MotorDynamicsLab/Nitehawk-SB-V2/Hardware/Nitehawk-SB_V2.0.0/Nitehawk-SB_V2.0.0_Layout.png

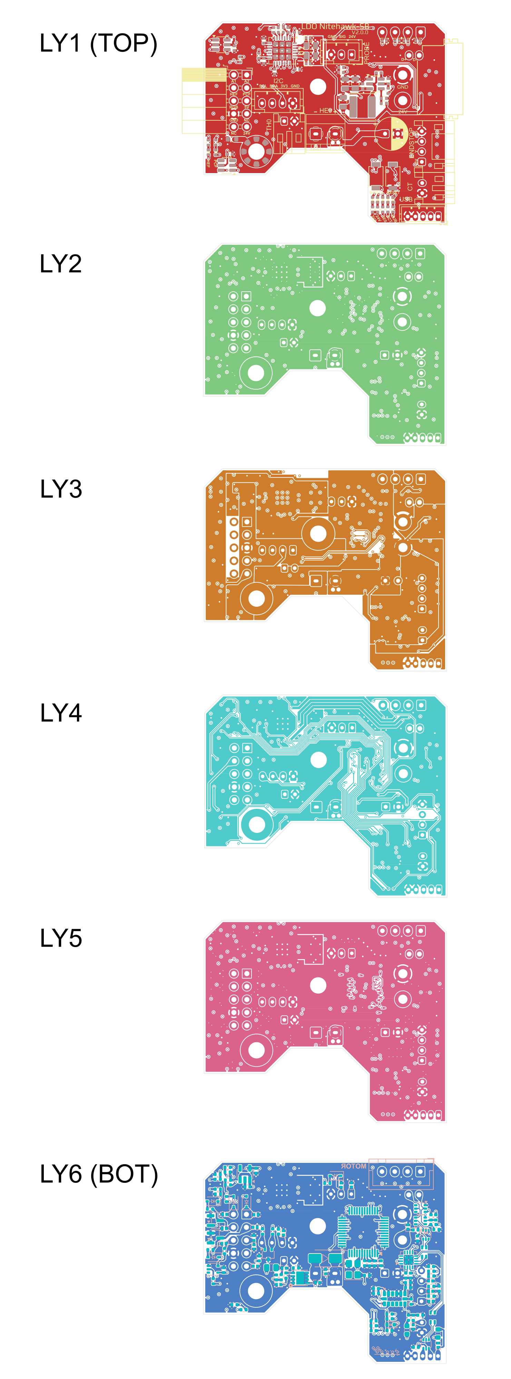
Hardware/Nitehawk-SB_V2.0.0/Nitehawk-SB_V2.0.0_Layout.png
