MotorDynamicsLab/Nitehawk-SB-V2/Images/block_diagram.jpg

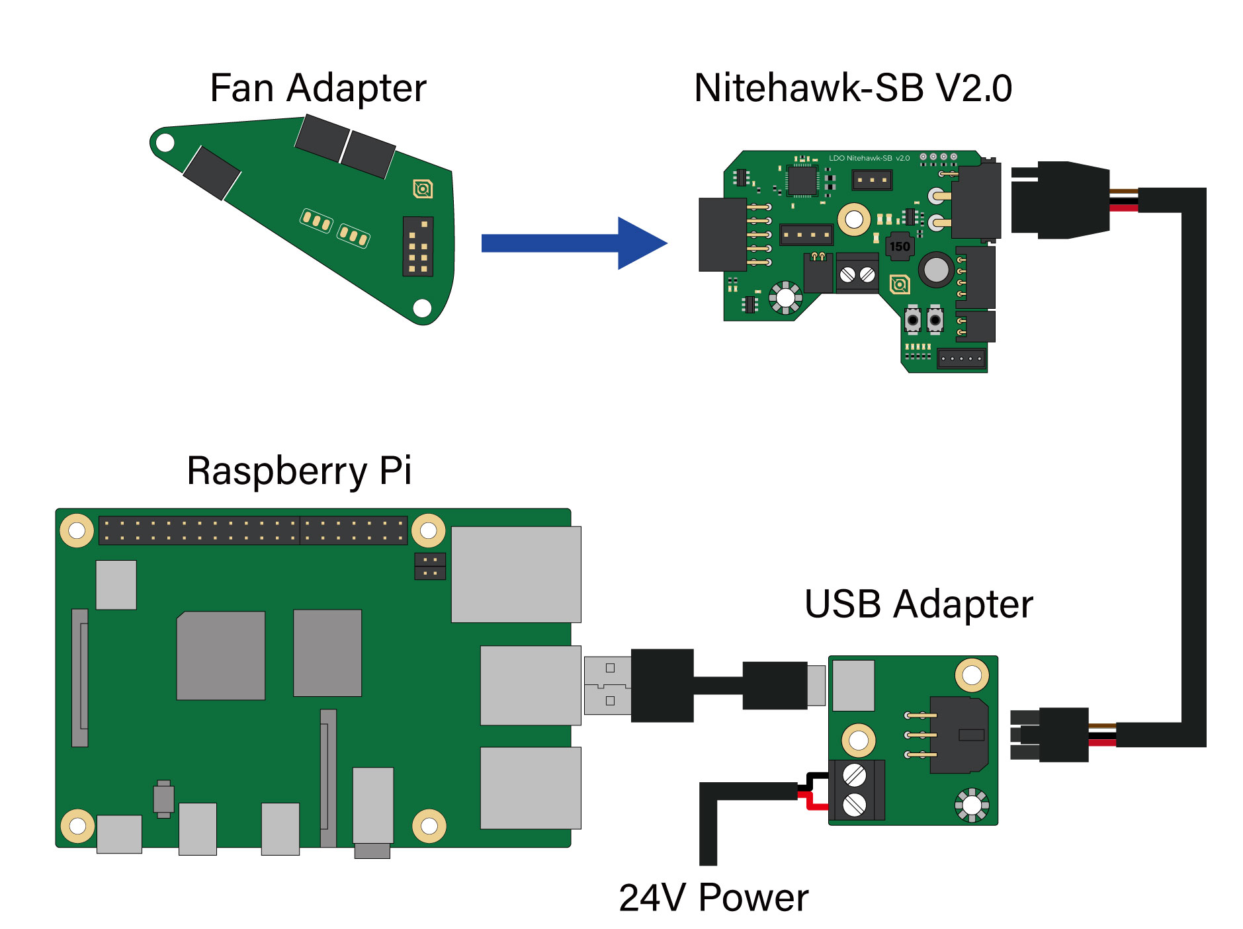
Images/block_diagram.jpg
