MotorDynamicsLab/Nitehawk-SB-V2/Images/cable_chain_ties.jpg

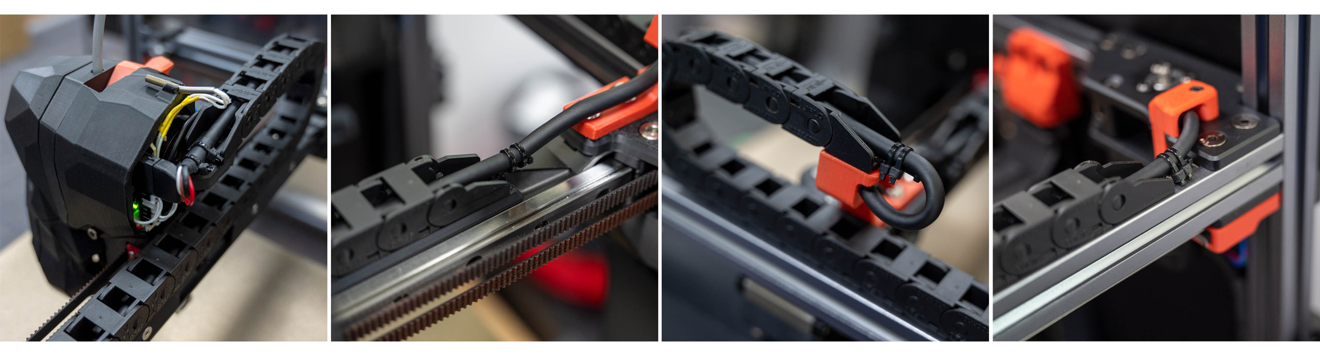
Images/cable_chain_ties.jpg
