MotorDynamicsLab/Nitehawk-SB-V2/Images/grounding_scheme.jpg

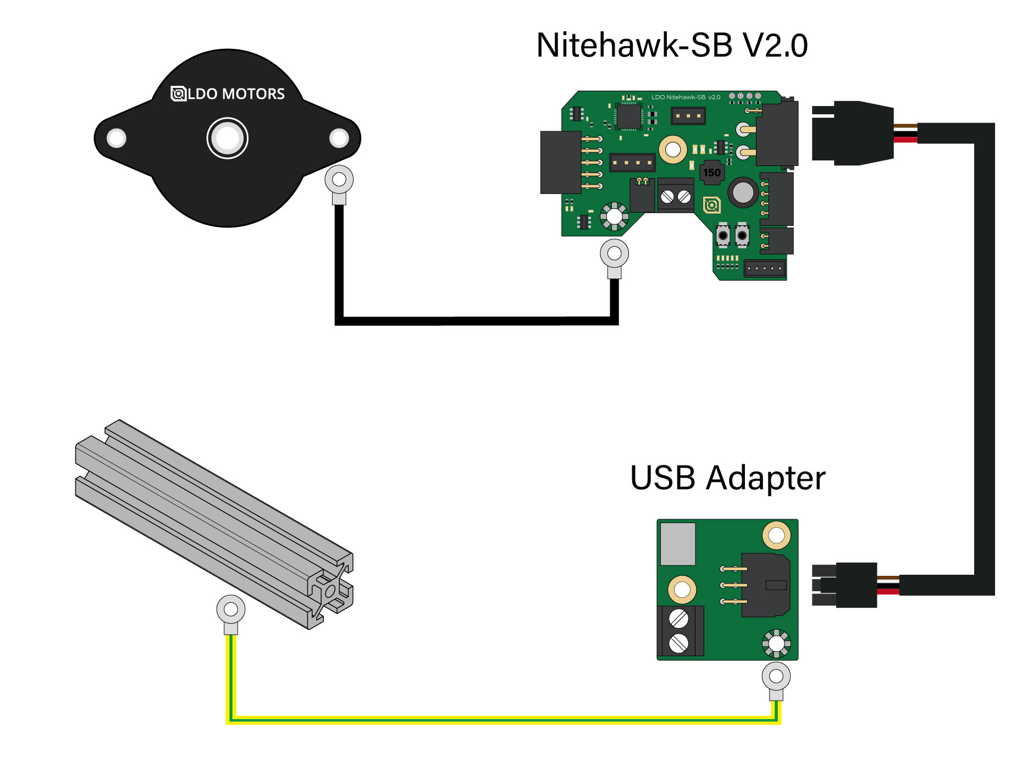
Images/grounding_scheme.jpg
