MotorDynamicsLab/Nitehawk-SB-V2/Images/katapult_menuconfig.png

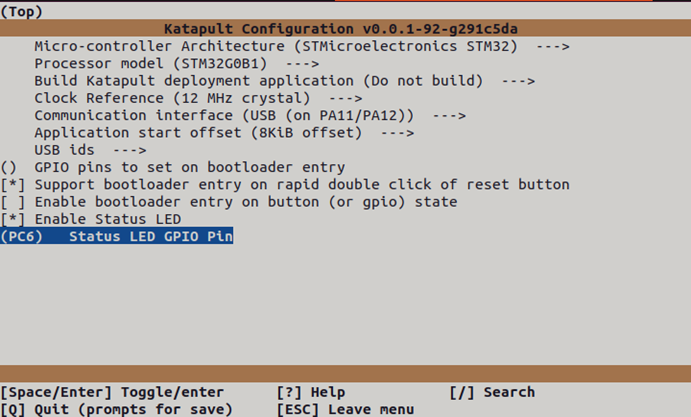
Images/katapult_menuconfig.png
