MotorDynamicsLab/Nitehawk-SB-V2/Images/nhsbv2_pcb_pinout.jpg

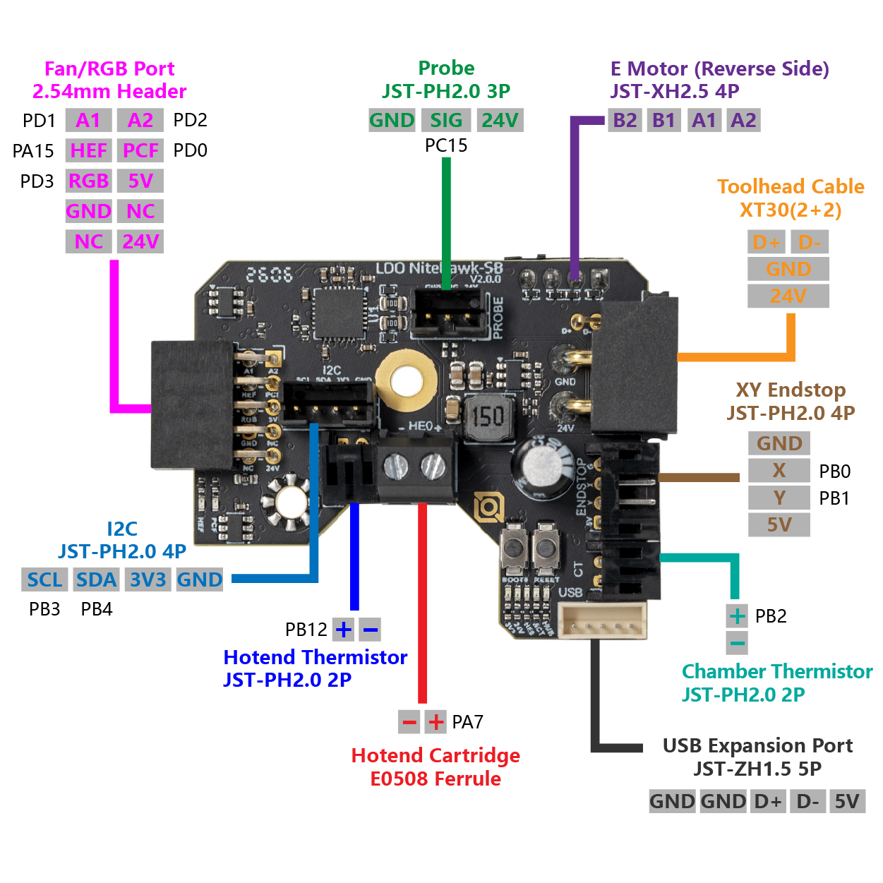
Images/nhsbv2_pcb_pinout.jpg
