MotorDynamicsLab/Nitehawk-SB-V2/Images/reset_boot_buttons.jpg

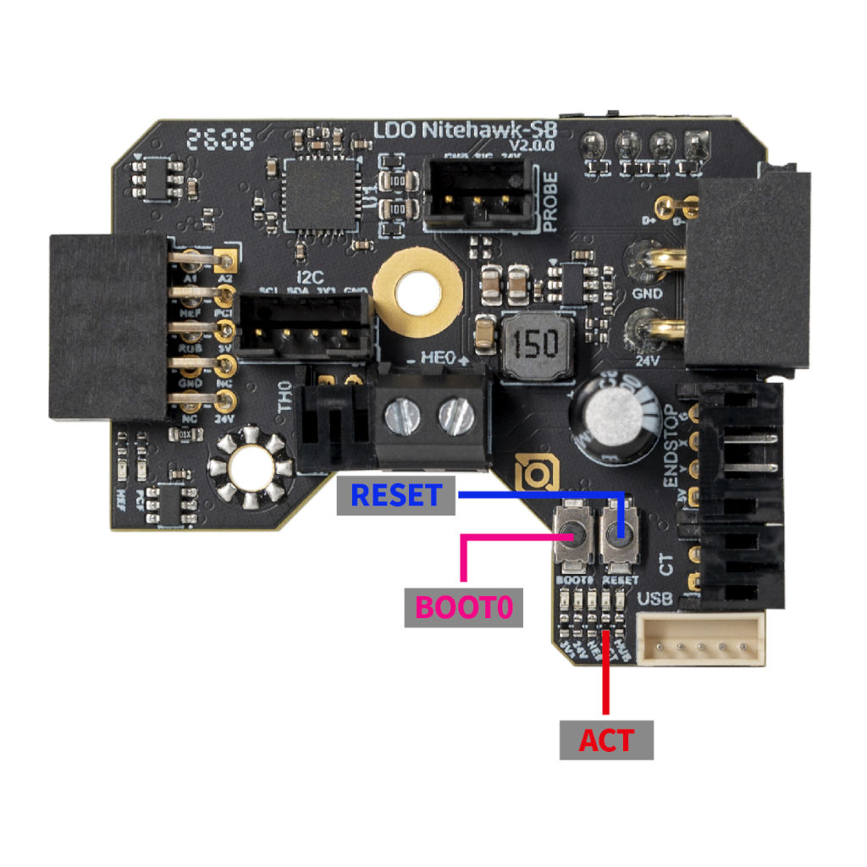
Images/reset_boot_buttons.jpg
