MotorDynamicsLab/Nitehawk-SB-V2/Images/sbv2_fan_adapter_pcb_pinout.jpg

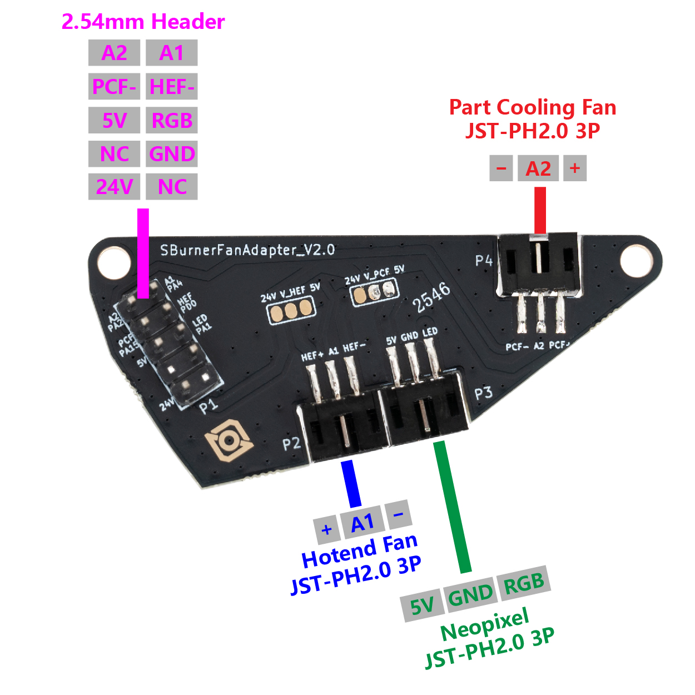
Images/sbv2_fan_adapter_pcb_pinout.jpg
