MotorDynamicsLab/Nitehawk-SB-V2/Images/toolboard_ground_routing.jpg

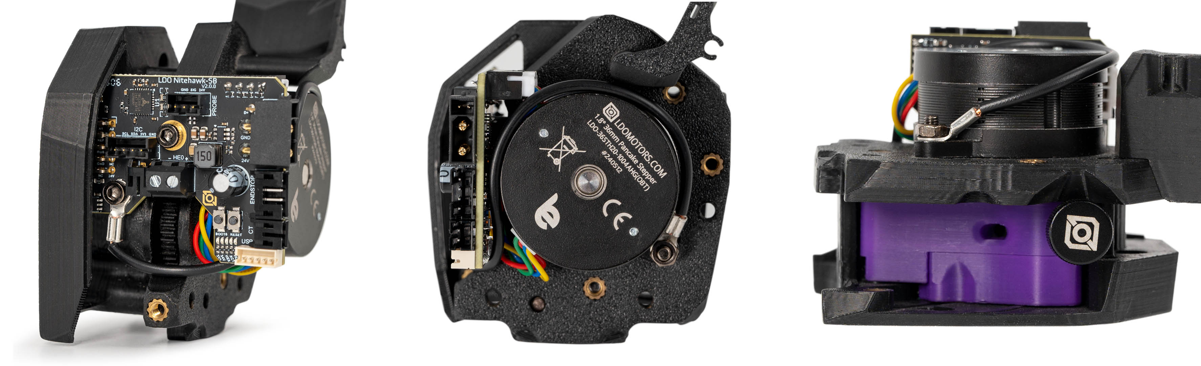
Images/toolboard_ground_routing.jpg
