MotorDynamicsLab/Nitehawk-SB-V2/Images/usb_adapter_gnd.jpg

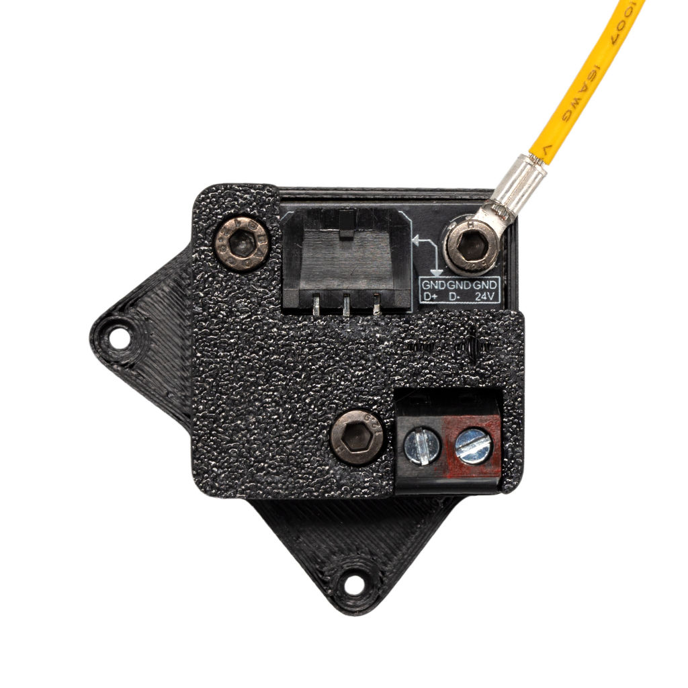
Images/usb_adapter_gnd.jpg
