MotorDynamicsLab/Nitehawk-SB-V2/STLs/usb_adapter_mount_partial_cover.stl

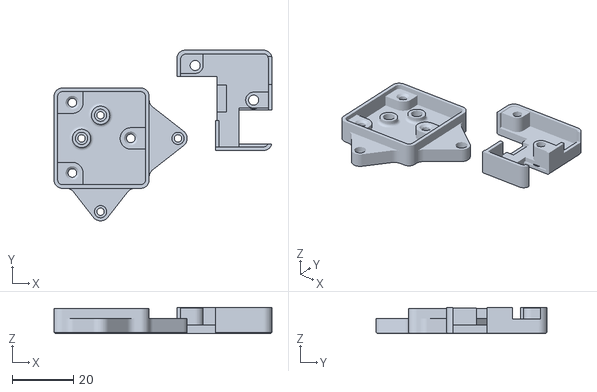
[picture p12: CAD file, 2026-01-09]
STLs/usb_adapter_mount_partial_cover.stl
71.2 x 55.8 x 8.60
