MotorDynamicsLab/Nitehawk-SB-V2/Hardware/Nitehawk-SB_V2.0.0/Nitehawk-SB_V2.0.0_Schematics.pdf.pdf

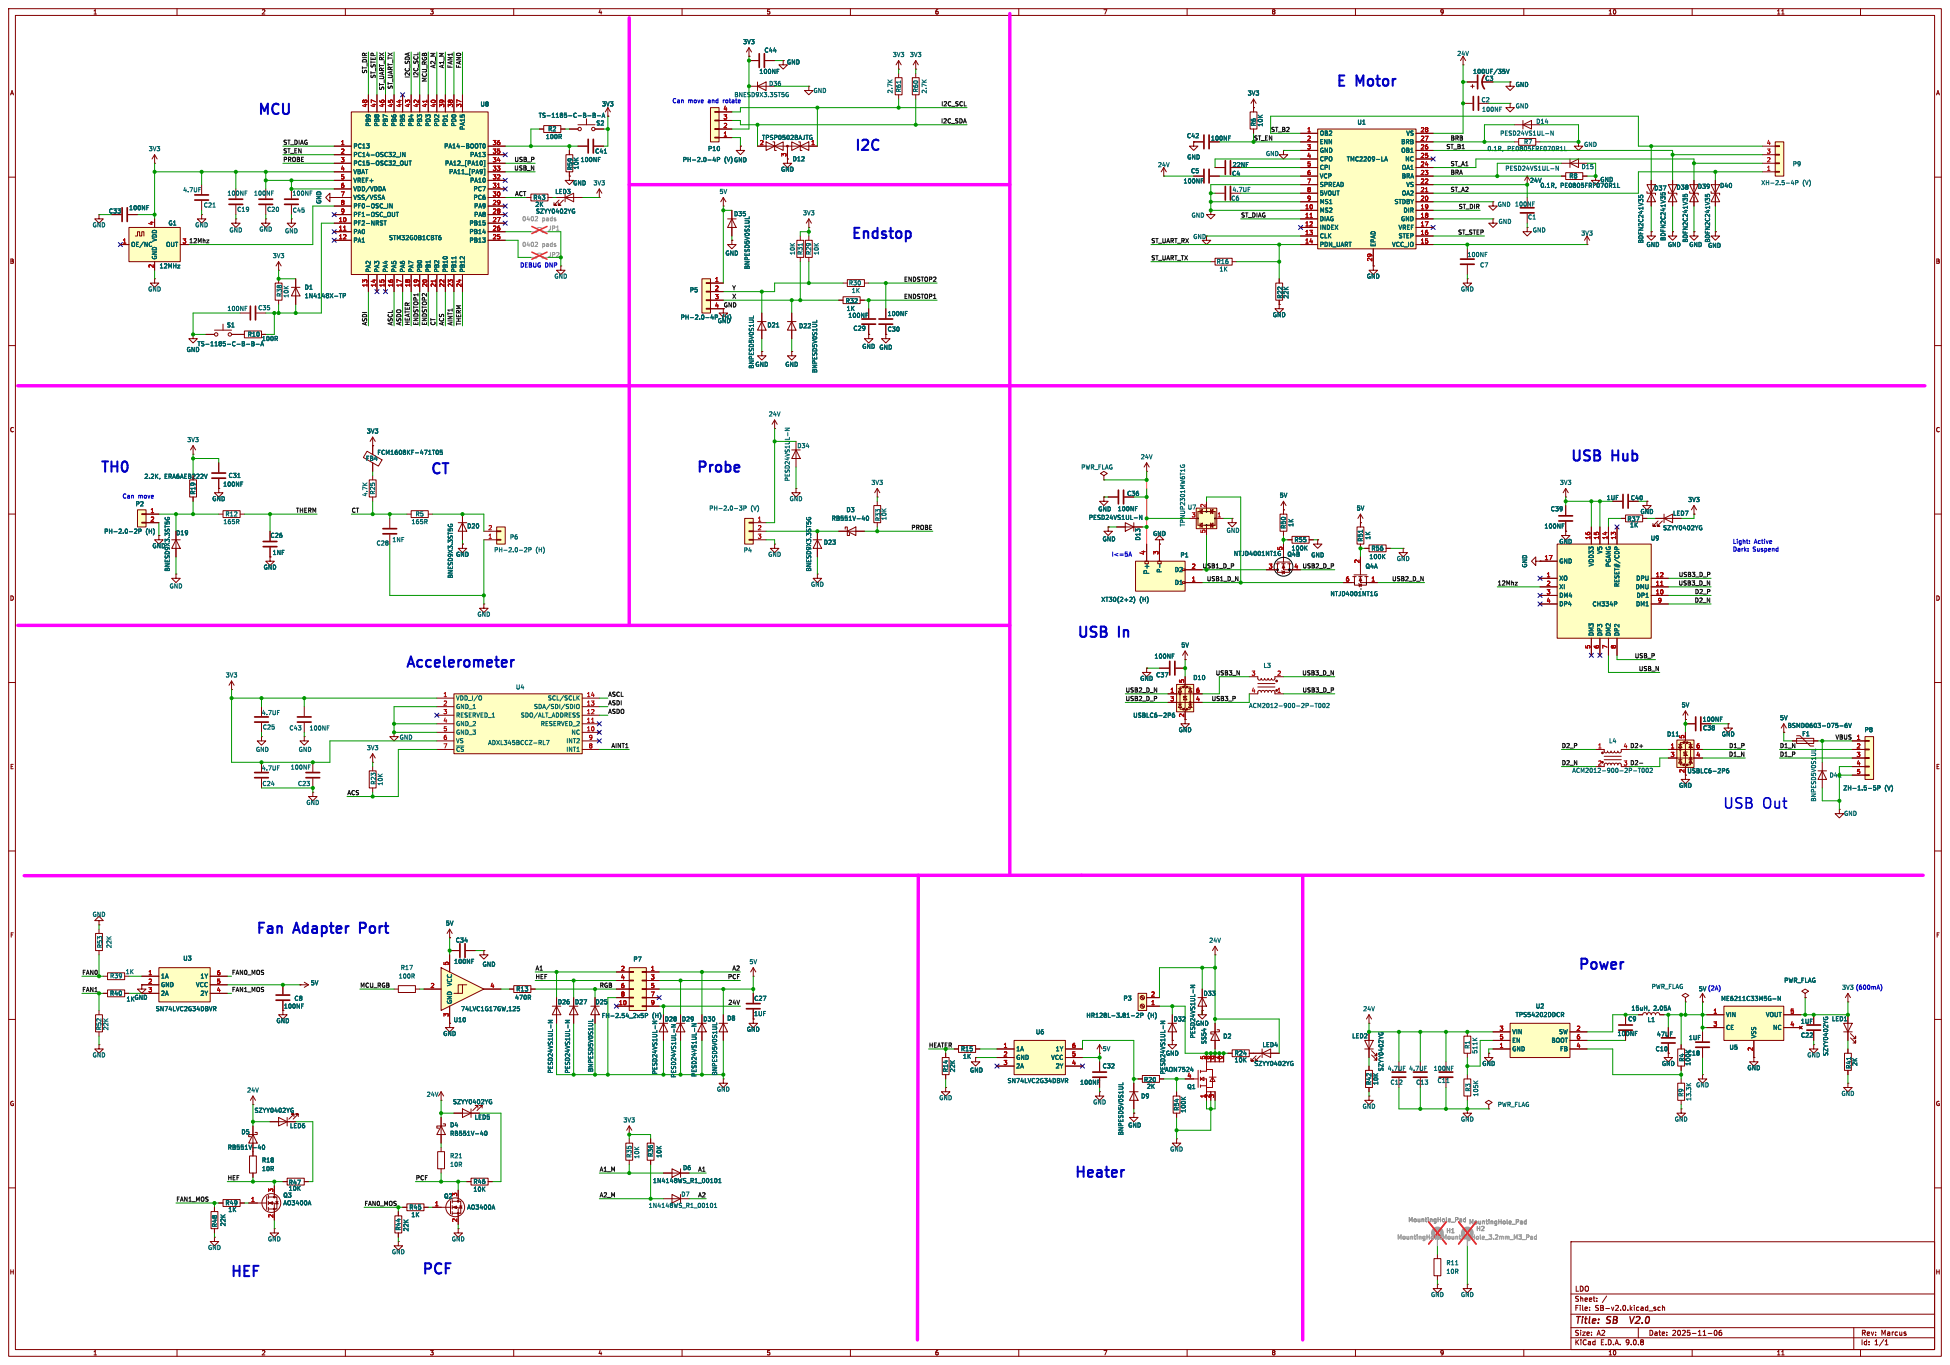
[picture p13: page 1]

File: SB-v2.0.kicad_sch Sheet: / LDO
