MotorDynamicsLab/Nitehawk-SB-V2/Hardware/Nitehawk-SB_V2.0.0/Nitehawk-SB_V2.0.0_Schematics.pdf

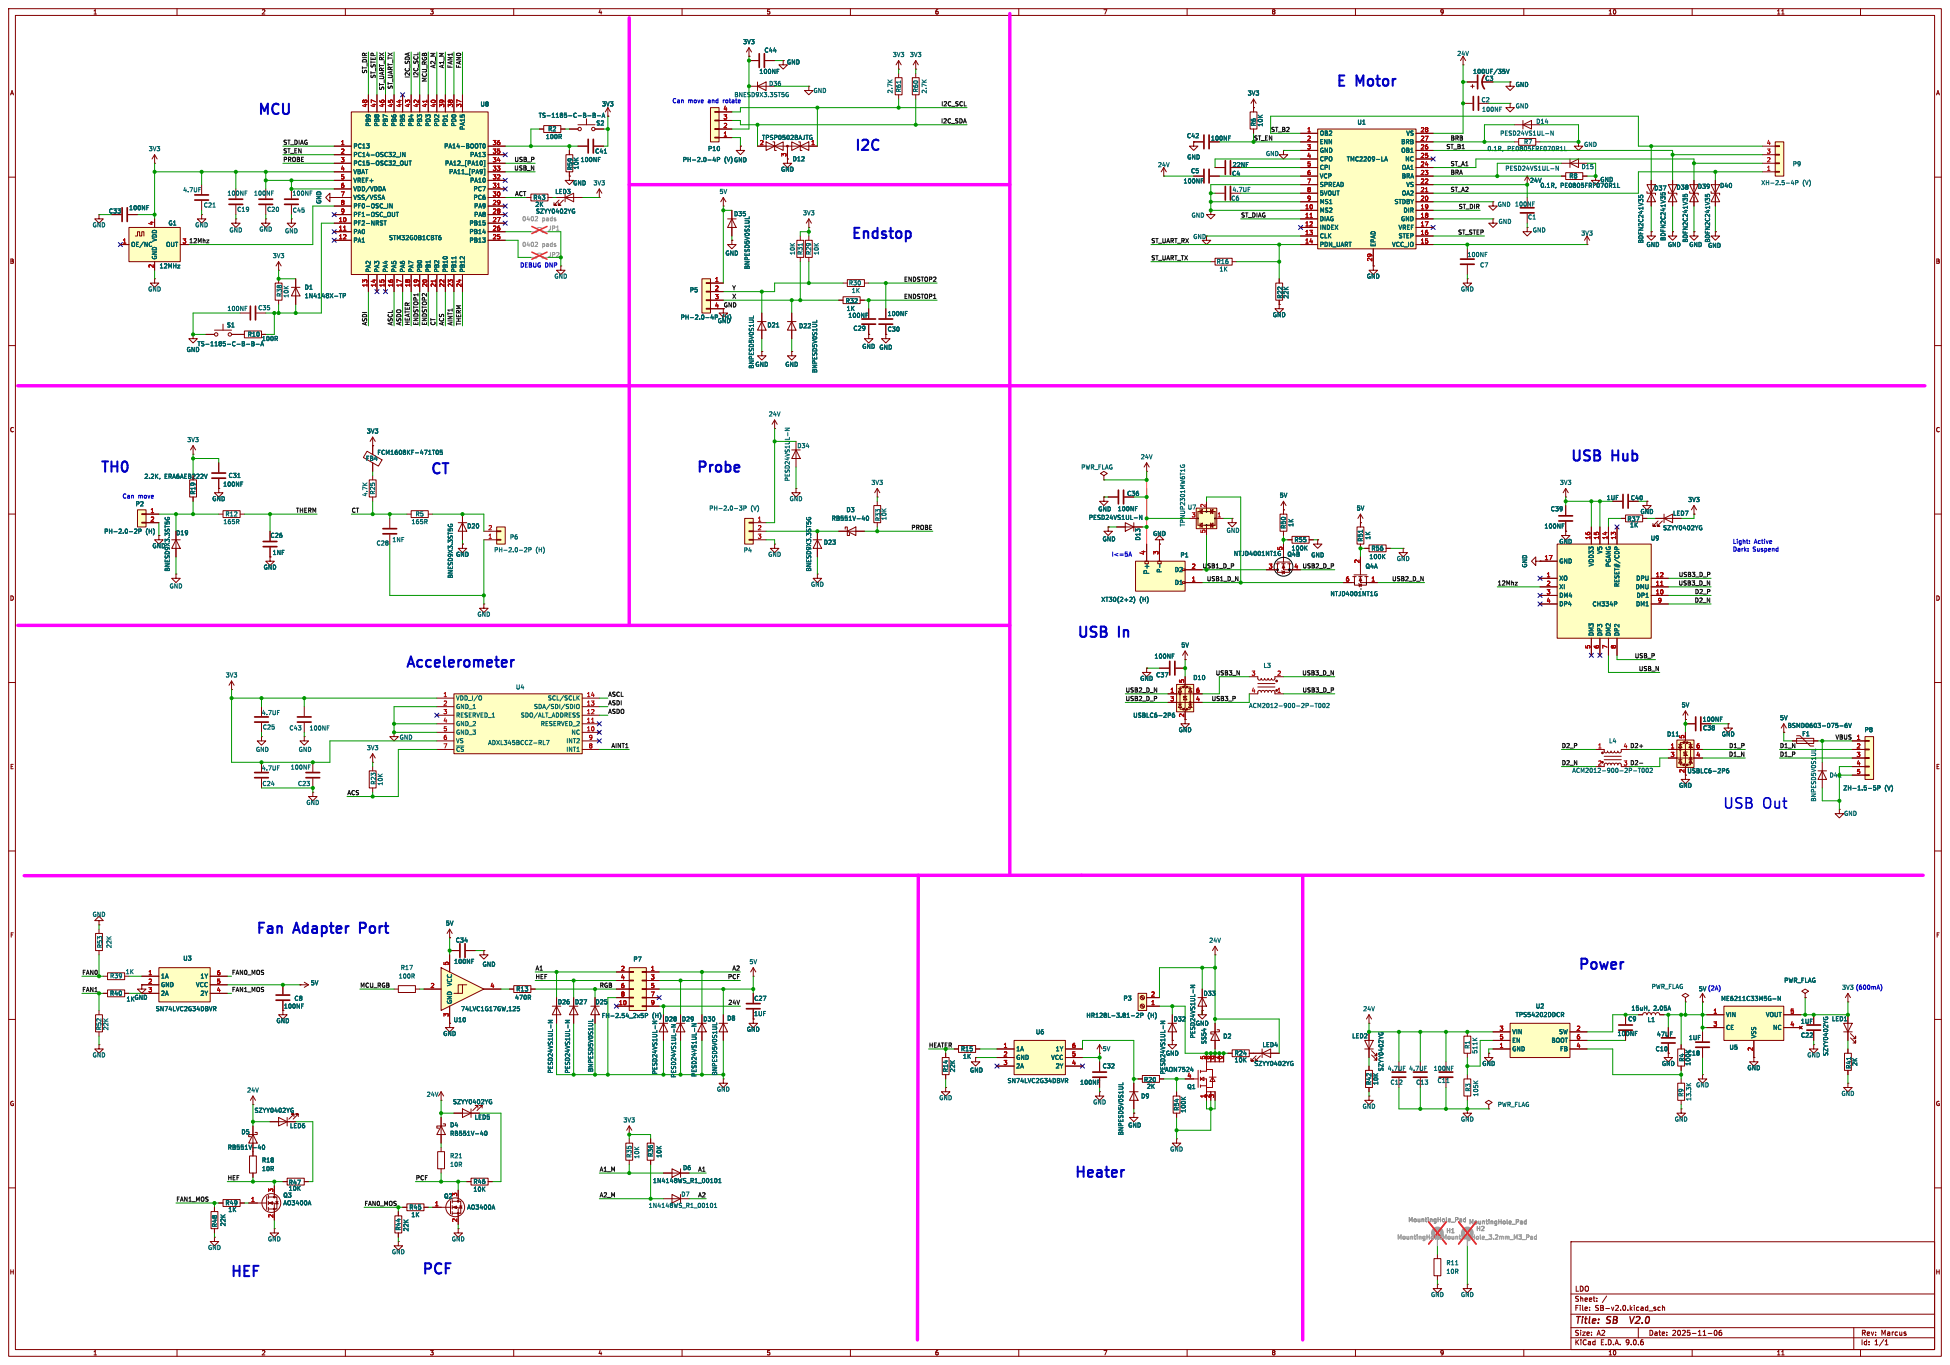
[picture p14: page 1]

Can move and rotate MCU

ST_B1 ASCL ASDO HEATER ENDSTOP1 ENDSTOP2 CTACS
0.1R, PE0805FRF070R1L C28 1NF

File: SB-v2.0.kicad_sch Sheet: / LDO
