MotorDynamicsLab/Nitehawk-SB-V2/Images/make_menuconfig.png

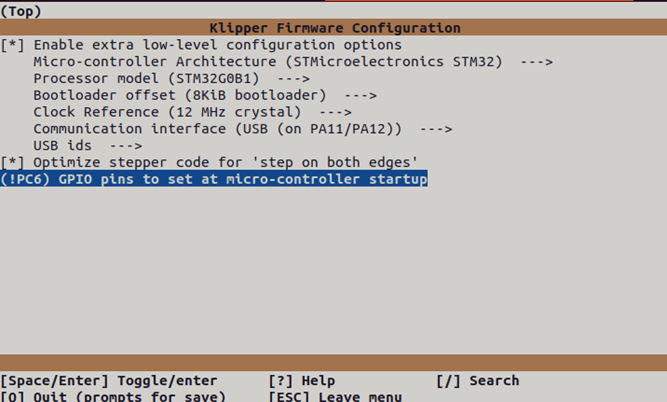
Images/make_menuconfig.png
