MotorDynamicsLab/Nitehawk-SB-V2/Configs/nitehawk-sbv2.cfg

# This file contains pin mappings for the LDO Nitehawk-SB V2 Toolboard
# Make sure to include this config *at the end* of printer.cfg to overwrite the relevent sections

# See http://docs.ldomotors.com/toolboard/nitehawk-sbv2#firmware-setup-and-update
# For instructions on uploading/updating klipper firmware to the onboard MCU

# Klipper make menuconfig options:
# Processor model: STM32G0B1
# Bootloader offset (for Katapult): 8KiB bootloader
# Clock Reference: 12Mhz crystal
# Communication interface: USB (on PA11/PA12)


## LDO Nitehawk-SB V2 Toolboard Partial Config

## *** THINGS TO CHANGE/CHECK: ***
## MCU paths                            [mcu] section
## Endstop pins to enable or disable    [stepper_x] and [stepper_y] sections
## Extruder motor current               [tmc2209 extruder] section
## Chamber thermistor type              [temperature_sensor chamber_temp] section

## *MAKE SURE* to include this partial config file *AFTER* the main controller config. 
## This will ensure the relavent sections are overwritten by the picobilical mappings specified here.

[mcu nhk]
##  Obtain definition by "ls -l /dev/serial/by-id/" then unplug to verify
##--------------------------------------------------------------------
serial:/dev/serial/by-path/usb-Klipper_STM32_E012345678900000-if00
restart_method: command
##--------------------------------------------------------------------


#####################################################################
#   Endstops
#####################################################################
## XES - Toolhead PCB
#[stepper_x]
#endstop_pin: nhk:PB0

## YES - Toolhead PCB
#[stepper_y]
#endstop_pin: nhk:PB1


#####################################################################
# 	Extruder
#####################################################################
[extruder]
step_pin: nhk:PB8
dir_pin: nhk:PB9
enable_pin: !nhk:PC14
heater_pin: nhk:PA7
sensor_pin: nhk:PB12
pullup_resistor: 2200

[tmc2209 extruder]
sense_resistor: 0.100
uart_pin: nhk:PB7
tx_pin: nhk:PB6
#diag_pin: nhk:PC13
interpolate: false
run_current: 0.5     #recommend setting below 0.7A.


#####################################################################
#   Fans
#####################################################################
## PCF
[fan] 
pin: nhk:PA15
#tachometer_pin: nhk:PD2
#tachometer_ppr: 2

## HEF
[heater_fan hotend_fan] 
pin: nhk:PD0
#tachometer_pin: nhk:PD1
#tachometer_ppr: 2


#####################################################################
# 	Probe
#####################################################################
## Probe Port
[probe]
pin: nhk:PC15


#####################################################################
#   Lights
#####################################################################
##Stealthburner Headlights
[neopixel sb_leds]
pin: nhk:PD3
chain_count: 3
color_order: GRBW
initial_RED: 0.0
initial_GREEN: 0.0
initial_BLUE: 0.0
initial_WHITE: 0.0

[output_pin act_led]
pin: nhk:PC6


#####################################################################
#   Accelerometer
#####################################################################
[adxl345]
cs_pin: nhk:PB10
spi_software_sclk_pin: nhk:PA5
spi_software_mosi_pin: nhk:PA2
spi_software_miso_pin: nhk:PA6

[resonance_tester]
accel_chip: adxl345
accel_per_hz: 100
sweeping_accel: 400
sweeping_period: 0
##--------------------------------------------------------------------
## Uncomment below for 250mm build
#probe_points:
#    125, 125, 20

## Uncomment below for 300mm build
#probe_points:
#    155, 155, 20

## Uncomment below for 350mm build
#probe_points:
#    175, 175, 20


#####################################################################
#   Thermistors
#####################################################################
[temperature_sensor chamber_temp]
sensor_type: Generic 3950
sensor_pin: nhk:PB2
pullup_resistor: 4700
min_temp: 0
max_temp: 100
gcode_id: chamber_th


#####################################################################
#   I2C port
#####################################################################
#i2c_software_scl_pin: nhk:PB3
#i2c_software_sda_pin: nhk:PB4
