MotorDynamicsLab/Nitehawk-SB-V2/(commit log)

2025-12-22 add klipper config file
2025-12-26 fix incorrect fan configs
2025-12-26 Add files via upload
    Fix fan pin error
2026-01-09 add partially covered usb adapter mount
2026-01-13 upload schematics and ibom
2026-01-14 add PCB layout image
2026-11-11 add fan board
